paulc/ch32v203-minimal/jlcpcb/production_files/BOM-ch32v203-minimal.csv

Comment | Designator | Footprint | LCSC | Quantity
100nF | C12,C3,C4,C5,C9 | C_1206_3216Metric_Pad1.33x1.80mm_HandSolder | C24497 | 5
10K | R1,R4 | R_1206_3216Metric_Pad1.30x1.75mm_HandSolder | C17902 | 2
10uF | C1 | C_1206_3216Metric_Pad1.33x1.80mm_HandSolder | C13585 | 1
1M | R5,R6 | R_1206_3216Metric_Pad1.30x1.75mm_HandSolder | C17927 | 2
1uF | C6 | C_1206_3216Metric_Pad1.33x1.80mm_HandSolder | C1848 | 1
20pF | C7,C8 | C_1206_3216Metric_Pad1.33x1.80mm_HandSolder | C377026 | 2
4.7uF | C10,C11,C2 | C_1206_3216Metric_Pad1.33x1.80mm_HandSolder | C29823 | 3
470R | R2 | R_1206_3216Metric_Pad1.30x1.75mm_HandSolder | C2930375 | 1
4K7 | R3 | R_1206_3216Metric_Pad1.30x1.75mm_HandSolder | C17936 | 1
8MHz | Y1 | Crystal_SMD_3225-4Pin_3.2x2.5mm_HandSoldering | C400090 | 1
AO3401A | Q1,Q2 | SOT-23 | C15127 | 2
B5819W SL | D3 | D_SOD-123 | C8598 | 1
CH32V203K8T6 | U2 | LQFP-32_7x7mm_P0.8mm | C5372188 | 1
LED | D1 | LED_1206_3216Metric_Pad1.42x1.75mm_HandSolder | C3646937 | 1
MCP1700x-330xxMB | U3 | SOT-89-3 | C632000 | 1
MCP73831-2-OT | U4 | SOT-23-5 | C424093 | 1
SW_Push | SW1,SW2 | 3_4_2 SMD Micro Touch Switch Button | C843659 | 2
Conn_02x10_Odd_Even | J5 | PinHeader_2x10_P2.54mm_Vertical |  | 1
Conn_01x04 | J4 | PinHeader_1x04_P2.54mm_Vertical |  | 1
Conn_01x04 | J3 | PinHeader_1x04_P2.54mm_Vertical |  | 1
Conn_01x08 | J1 | PinHeader_1x08_P2.54mm_Vertical |  | 1
Conn_01x02_Pin | J2 | JST_PH_B2B-PH-K_1x02_P2.00mm_Vertical |  | 1
TestPoint | TP9 | Proto-1x4 |  | 1
TestPoint | TP10 | Proto-1x4 |  | 1
TestPoint | TP13 | Proto-1x4 |  | 1
TestPoint | TP15 | Proto-1x4 |  | 1
TestPoint | TP7 | Proto-1x4 |  | 1
TestPoint | TP17 | Proto-1x4 |  | 1
TestPoint | TP12 | Proto-1x4 |  | 1
TestPoint | TP3 | Proto-1x4 |  | 1
TestPoint | TP16 | Proto-1x4 |  | 1
TestPoint | TP4 | Proto-1x4 |  | 1
TestPoint | TP14 | Proto-1x4 |  | 1
TestPoint | TP11 | Proto-1x4 |  | 1
TestPoint | TP6 | Proto-1x4 |  | 1
TestPoint | TP8 | Proto-1x4 |  | 1
TestPoint | TP1 | Proto-1x16 |  | 1
TestPoint | TP5 | Proto-1x4 |  | 1
TestPoint | TP2 | Proto-1x16 |  | 1
TestPoint | TP18 | Proto-1x4 |  | 1
Chg Stat | TP20 | TP-PlatedHole |  | 1
Vbat/2 | TP19 | TP-PlatedHole |  | 1
