paulc/ch32v203-minimal/ch32v203-minimal.kicad_pcb

## KiCad design ch32v203-minimal.kicad_pcb (2026-10-06)

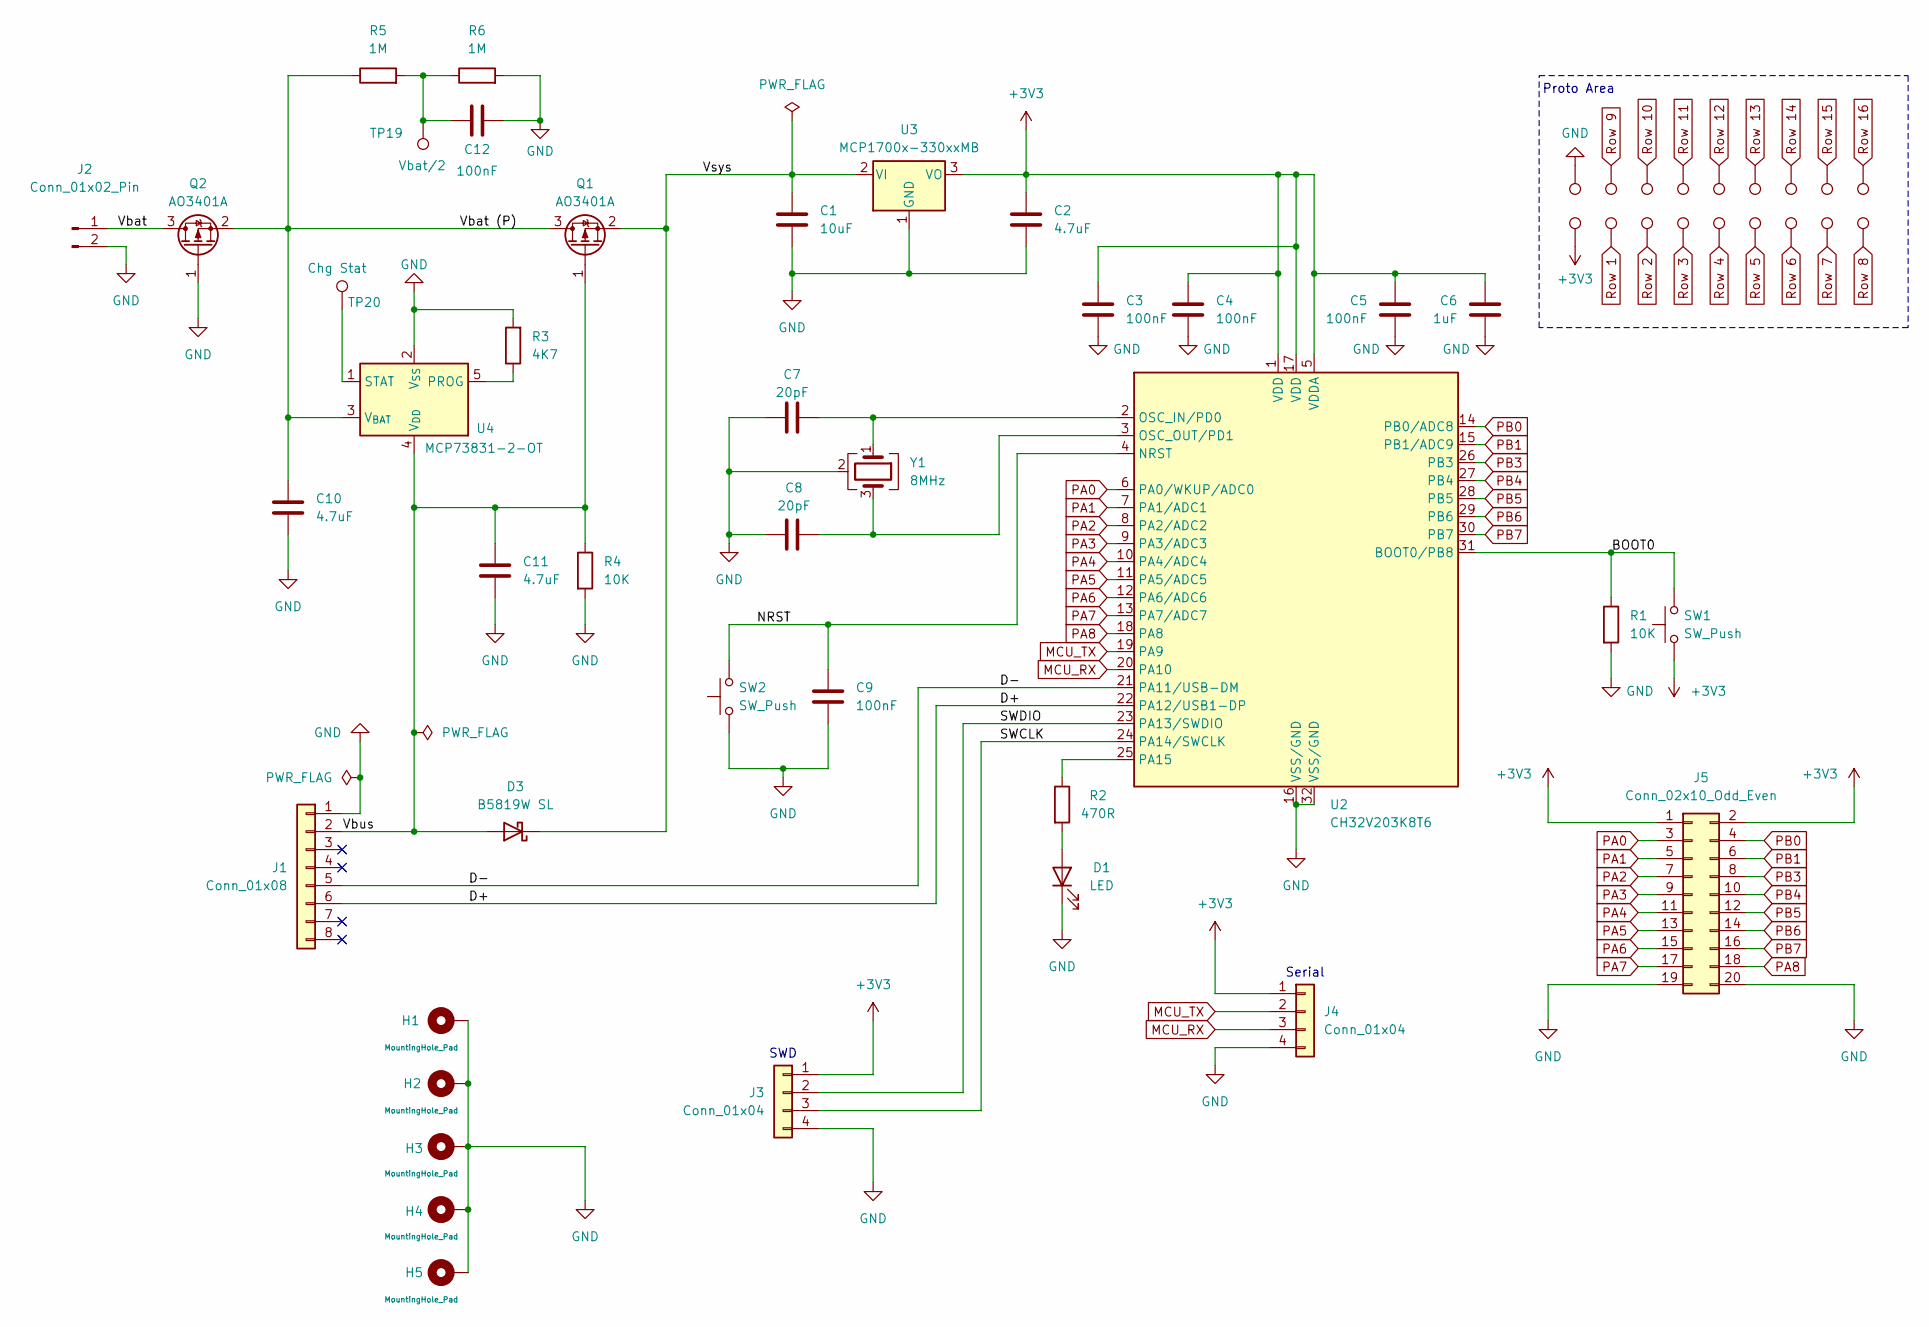
[picture p1: schematic ch32v203-minimal.kicad_sch]

Parts:
C1: 10uF; C_1206_3216Metric_Pad1.33x1.80mm_HandSolder; LCSC C13585
C2, C10, C11: 4.7uF; C_1206_3216Metric_Pad1.33x1.80mm_HandSolder; LCSC C29823
C3, C4, C5, C9, C12: 100nF; C_1206_3216Metric_Pad1.33x1.80mm_HandSolder; LCSC C24497
C6: 1uF; C_1206_3216Metric_Pad1.33x1.80mm_HandSolder; LCSC C1848
C7, C8: 20pF; C_1206_3216Metric_Pad1.33x1.80mm_HandSolder; LCSC C377026
D1: LED; LED_1206_3216Metric_Pad1.42x1.75mm_HandSolder; LCSC C3646937
D3: B5819W SL; D_SOD-123; LCSC C8598
H1, H2, H3, H4, H5: MountingHole_Pad; MountingHole_2.2mm_M2_DIN965_Pad
J1: Conn_01x08; PinHeader_1x08_P2.54mm_Vertical
J2: Conn_01x02_Pin; JST_PH_B2B-PH-K_1x02_P2.00mm_Vertical
J3, J4: Conn_01x04; PinHeader_1x04_P2.54mm_Vertical
J5: Conn_02x10_Odd_Even; PinHeader_2x10_P2.54mm_Vertical
Q1, Q2: AO3401A; SOT-23; LCSC C15127
R1, R4: 10K; R_1206_3216Metric_Pad1.30x1.75mm_HandSolder; LCSC C17902
R2: 470R; R_1206_3216Metric_Pad1.30x1.75mm_HandSolder; LCSC C2930375
R3: 4K7; R_1206_3216Metric_Pad1.30x1.75mm_HandSolder; LCSC C17936
R5, R6: 1M; R_1206_3216Metric_Pad1.30x1.75mm_HandSolder; LCSC C17927
SW1, SW2: SW_Push; 3_4_2 SMD Micro Touch Switch Button; LCSC Part C843659
TP1, TP2: TestPoint; Proto-1x16
TP3, TP4, TP5, TP6, TP7, TP8, TP9, TP10, TP11, TP12, TP13, TP14, TP15, TP16, TP17, TP18: TestPoint; Proto-1x4
TP19: Vbat/2; TP-PlatedHole
TP20: Chg Stat; TP-PlatedHole
U2: CH32V203K8T6; LQFP-32_7x7mm_P0.8mm; LCSC C5372188
U3: MCP1700x-330xxMB; SOT-89-3; LCSC C632000
U4: MCP73831-2-OT; SOT-23-5; LCSC C424093
Y1: 8MHz; Crystal_SMD_3225-4Pin_3.2x2.5mm_HandSoldering; LCSC C400090

Connections:
+3V3: C2.1, C3.1, C4.1, C5.1, C6.1, J3.1, J4.1, J5.1, J5.2, SW1.1, TP2.1 (1_1), U2.1 (VDD), U2.5 (VDDA), U2.17 (VDD), U3.3 (VO)
/BOOT0: R1.1, SW1.2, U2.31 (BOOT0/PB8)
/D+: J1.6, U2.22 (PA12/USB1-DP)
/D-: J1.5, U2.21 (PA11/USB-DM)
/NRST: C9.1, SW2.2, U2.4 (NRST)
/SWCLK: J3.3, U2.24 (PA14/SWCLK)
/SWDIO: J3.2, U2.23 (PA13/SWDIO)
/Vbat: J2.1, Q2.3 (D)
/Vbat (P): C10.1, Q1.3 (D), Q2.2 (S), R5.1, U4.3 (V_{BAT})
/Vbus: C11.1, D3.2 (A), J1.2, Q1.1 (G), R4.1, U4.4 (V_{DD})
/Vsys: C1.1, D3.1 (K), Q1.2 (S), U3.2 (VI)
GND: C1.2, C2.2, C3.2, C4.2, C5.2, C6.2, C7.1, C8.1, C9.2, C10.2, C11.2, C12.2, D1.1 (K), H1.1 (1_1), H2.1 (1_1), H3.1 (1_1), H4.1 (1_1), H5.1 (1_1), J1.1, J2.2, J3.4, J4.4, J5.19, J5.20, Q2.1 (G), R1.2, R3.2, R4.2, R6.2, SW2.1, TP1.1 (1_1), U2.16 (VSS/GND), U2.32 (VSS/GND), U3.1 (GND), U4.2 (V_{SS}), Y1.2 (G), Y1.4 (G)
MCU_RX: J4.3, U2.20 (PA10)
MCU_TX: J4.2, U2.19 (PA9)
unnamed: C12.1, R5.2, R6.1, TP19.1 (1_1)
unnamed: D1.2 (A), R2.2
unnamed: C7.2, U2.2 (OSC_IN/PD0), Y1.1
unnamed: C8.2, U2.3 (OSC_OUT/PD1), Y1.3
unnamed: R2.1, U2.25 (PA15)
unnamed: R3.1, U4.5 (PROG)
unnamed: TP20.1 (1_1), U4.1 (STAT)
PA0: J5.3, U2.6 (PA0/WKUP/ADC0)
PA1: J5.5, U2.7 (PA1/ADC1)
PA2: J5.7, U2.8 (PA2/ADC2)
PA3: J5.9, U2.9 (PA3/ADC3)
PA4: J5.11, U2.10 (PA4/ADC4)
PA5: J5.13, U2.11 (PA5/ADC5)
PA6: J5.15, U2.12 (PA6/ADC6)
PA7: J5.17, U2.13 (PA7/ADC7)
PA8: J5.18, U2.18 (PA8)
PB0: J5.4, U2.14 (PB0/ADC8)
PB1: J5.6, U2.15 (PB1/ADC9)
PB3: J5.8, U2.26 (PB3)
PB4: J5.10, U2.27 (PB4)
PB5: J5.12, U2.28 (PB5)
PB6: J5.14, U2.29 (PB6)
PB7: J5.16, U2.30 (PB7)
Row 1: TP3.1 (1_1)
Row 2: TP4.1 (1_1)
Row 3: TP5.1 (1_1)
Row 4: TP6.1 (1_1)
Row 5: TP7.1 (1_1)
Row 6: TP8.1 (1_1)
Row 7: TP9.1 (1_1)
Row 8: TP10.1 (1_1)
Row 9: TP11.1 (1_1)
Row 10: TP12.1 (1_1)
Row 11: TP13.1 (1_1)
Row 12: TP14.1 (1_1)
Row 13: TP15.1 (1_1)
Row 14: TP16.1 (1_1)
Row 15: TP17.1 (1_1)
Row 16: TP18.1 (1_1)

Notes on the sheet:
Serial
SWD
Proto Area

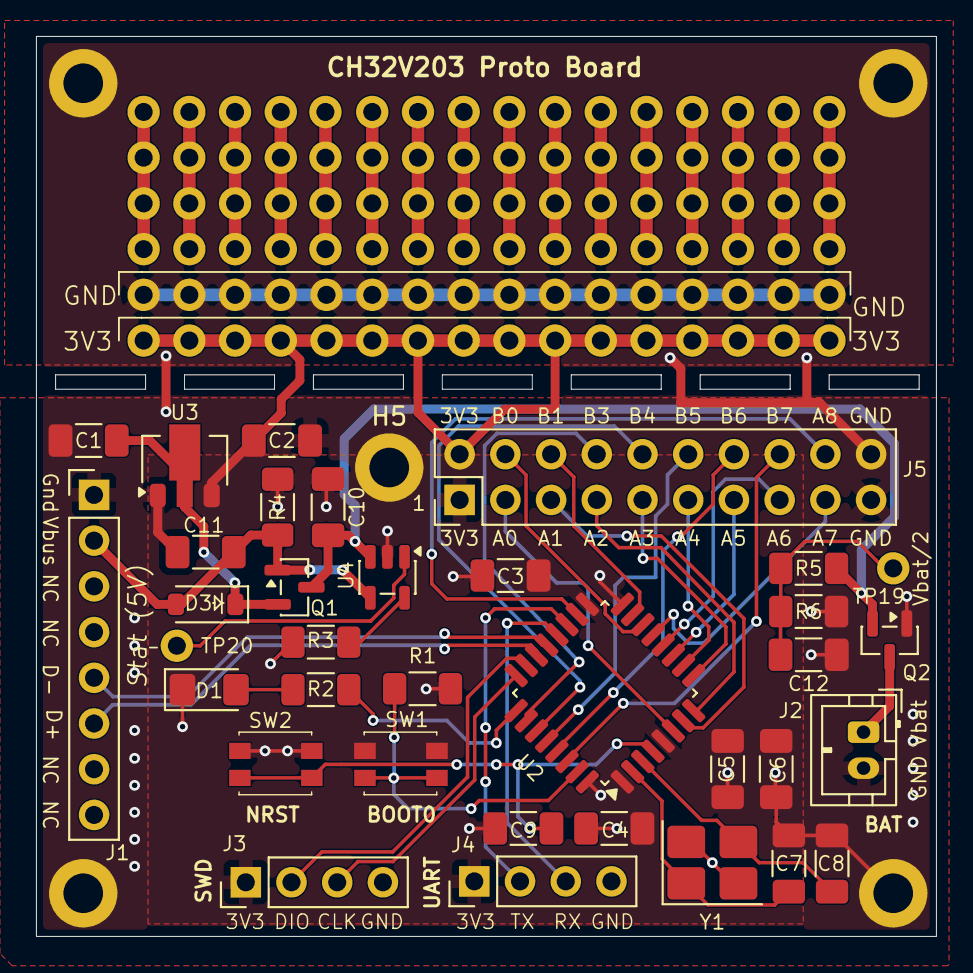
[picture p2: board ch32v203-minimal.kicad_pcb from above]

Board: 2 copper layers, 50.0 x 50.0 mm, 58 parts (0 on the bottom side), 37 nets.
