paulc/ch32v203-minimal/(commit log)

2026-09-25 Initial import
    [BOM-ch32v203-minimal.csv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]
2026-09-26 Rework layout
    [BOM-ch32v203-minimal.csv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]
2026-09-27 minor fixes
    [ch32v203-minimal-CuBottom.gbr, ch32v203-minimal-CuTop.gbr, ch32v203-minimal-EdgeCuts.gbr, ch32v203-minimal-MaskBottom.gbr, ch32v203-minimal-MaskTop.gbr, ch32v203-minimal-NPTH.drl, ch32v203-minimal-PTH.drl, ch32v203-minimal-PasteBottom.gbr]
2026-09-30 Add +5V connector
    [BOM-ch32v203-minimal.csv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]
2026-10-03 Add proto board
    [BOM-ch32v203-minimal.csv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]
2026-10-05 Swap LDO for MCP1700
    [BOM-ch32v203-minimal.csv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]
2026-10-06 Add battery-charging circuit
    [BOM-ch32v203-minimal.csv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]
2026-10-30 Completed v1.0 for fabrication
    [ch32v203-minimal.kicad_sch]
